villekl/EBC2013_1_2_PID/Main Board Eagle files/revB.brd

## EAGLE design Main Board Eagle files/revB.brd (2014-01-22, an earlier design)

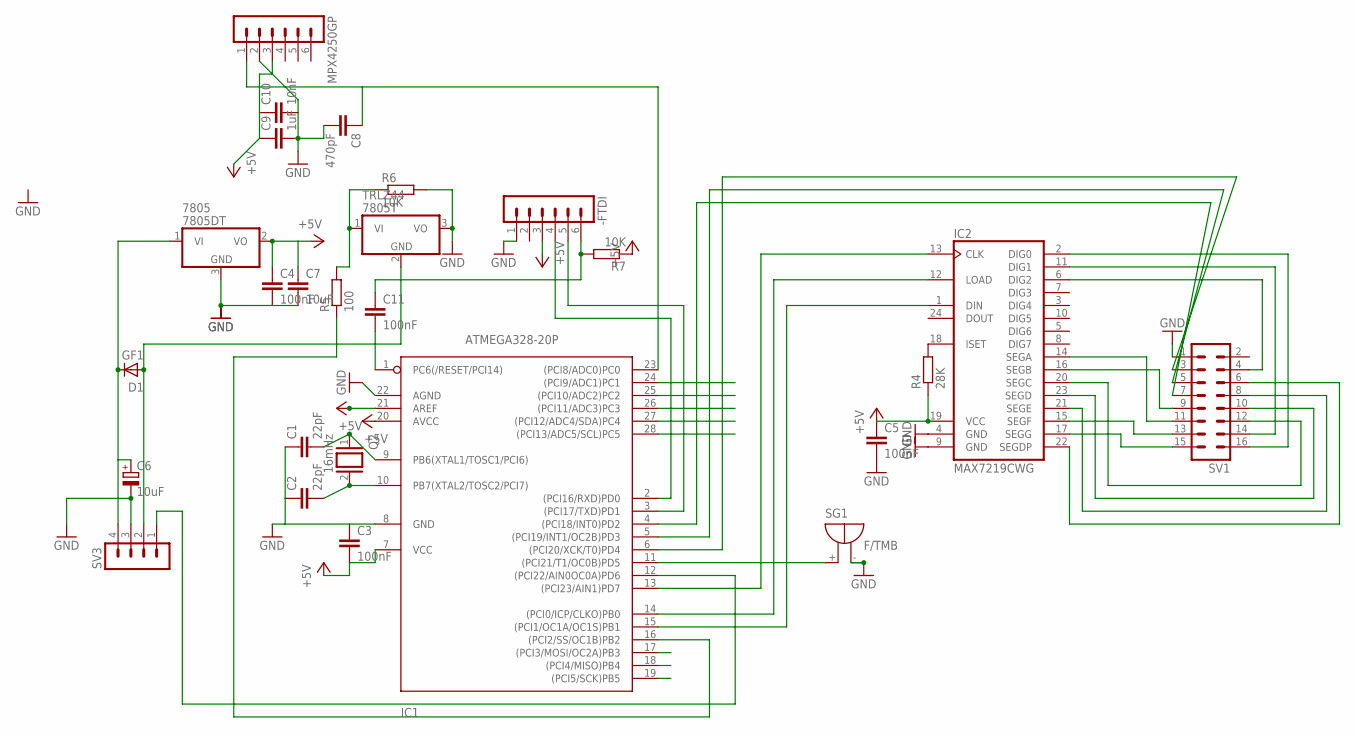
[picture p1: schematic revB.sch]

Parts:
7805: 7805DT; TO252
-FTDI: MA06-1
C1, C2: 22pF; C0805; MPN ERB21B5C2D220JDX1L
C3, C4, C5, C11: 100nF; C0805; MPN C0805X104K5RACTU
C6: 10uF; E2,5-6E
C7: 10uF; C0805; MPN C0805X104K5RACTU
C8: 470pF; C0805; MPN C0805X104K5RACTU
C9: 1uF; C0805; MPN C0805X104K5RACTU
C10: 10nF; C0805; MPN C0805X104K5RACTU
D1: GF1; SMA-DO214AC
IC1: ATMEGA328-20P; DIL28-3
IC2: MAX7219CWG
MPX4250GP: MA06-1
Q2: 16mHz; QS; MPN 16.000MHZ HC49/4H/30/50/40/18PF/ATF
R4: 28K; R0805
R5: 100; R0805
R6, R7: 10K; R0805
SG1: F/TMB
SV1: MA08-2
SV3: MA04-1
TRLZ44: 7805T; TO220H

Connections:
+5V: 7805.2 (VO), -FTDI.3, C3.2, C4.1, C5.1, C7.1, C9.1, C10.1, IC1.7 (VCC), IC1.20 (AVCC), IC1.21 (AREF), IC2.19 (VCC), MPX4250GP.3, R4.1, R7.1
GND: 7805.3 (GND), -FTDI.1, C1.1, C2.1, C3.1, C4.2, C5.2, C6.-, C7.2, C8.2, C9.2, C10.2, IC1.8 (GND), IC1.22 (AGND), IC2.4 (GND), IC2.9 (GND), MPX4250GP.2, R6.2, SG1.-, SV1.1, SV3.3, TRLZ44.3 (VO)
unnamed: C1.2, IC1.9 (PB6(XTAL1/TOSC1/PCI6)), Q2.1
unnamed: R5.2, R6.1, TRLZ44.1 (VI)
unnamed: IC1.15 ((PCI1/OC1A/OC1S)PB1), IC2.1 (DIN)
unnamed: IC2.6 (DIG2), SV1.4
unnamed: IC2.11 (DIG1), SV1.14
unnamed: IC2.22 (SEGDP), SV1.6
unnamed: IC2.21 (SEGE), SV1.8
unnamed: C8.1, IC1.23 ((PCI8/ADC0)PC0), MPX4250GP.1
unnamed: IC2.23 (SEGD), SV1.10
unnamed: IC2.20 (SEGC), SV1.12
unnamed: IC2.2 (DIG0), SV1.16
unnamed: IC2.17 (SEGG), SV1.15
unnamed: IC2.15 (SEGF), SV1.13
unnamed: IC2.14 (SEGA), SV1.11
unnamed: IC2.18 (ISET), R4.2
unnamed: IC1.16 ((PCI2/SS/OC1B)PB2), R5.1
unnamed: IC1.14 ((PCI0/ICP/CLKO)PB0), IC2.12 (LOAD)
unnamed: IC1.13 ((PCI23/AIN1)PD7), IC2.13 (CLK)
unnamed: IC1.4 ((PCI18/INT0)PD2), SV1.7
unnamed: IC1.5 ((PCI19/INT1/OC2B)PD3), SV1.5
unnamed: IC1.6 ((PCI20/XCK/T0)PD4), SV1.3
unnamed: IC1.11 ((PCI21/T1/OC0B)PD5), SG1.+
unnamed: -FTDI.6, C11.1, R7.2
unnamed: -FTDI.4, IC1.2 ((PCI16/RXD)PD0)
unnamed: -FTDI.5, IC1.3 ((PCI17/TXD)PD1)
unnamed: 7805.1 (VI), C6.+, D1.K (C), SV3.4
unnamed: C2.2, IC1.10 (PB7(XTAL2/TOSC2/PCI7)), Q2.2
unnamed: D1.A, SV3.2, TRLZ44.2 (GND)
unnamed: IC1.12 ((PCI22/AIN0OC0A)PD6), SV3.1
unnamed: IC2.16 (SEGB), SV1.9
unnamed: C11.2, IC1.1 (PC6(/RESET/PCI14))

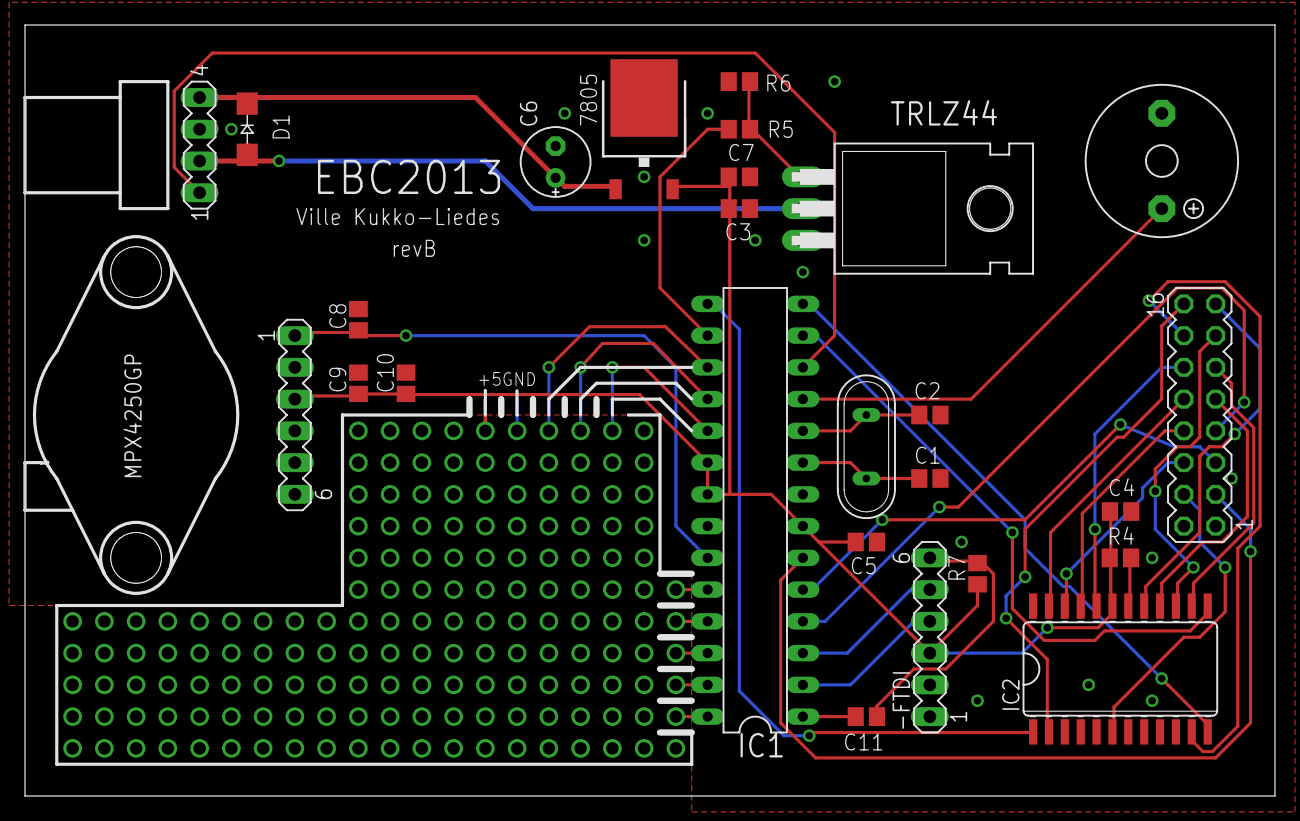
[picture p2: board revB.brd from above]

Board: 2 copper layers, 100.0 x 61.7 mm, 26 parts (0 on the bottom side), 33 nets.
