villekl/EBC2013_1_2_PID/Display Board Eagle files/rev19schem.brd

## EAGLE design Display Board Eagle files/rev19schem.brd (2014-01-22)

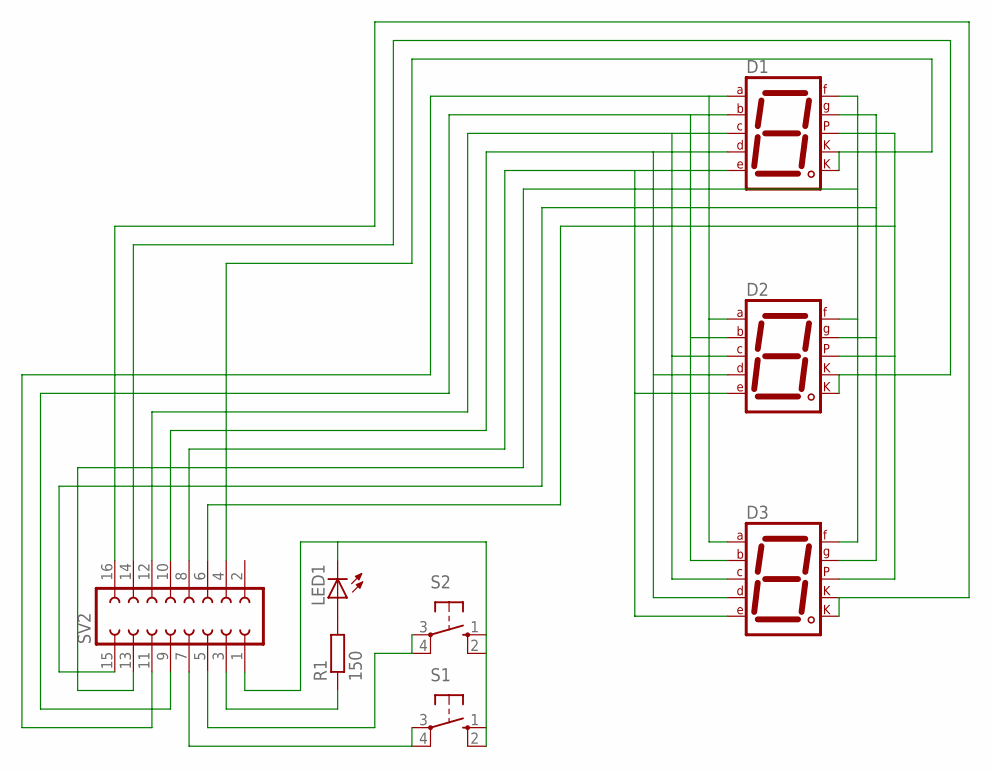
[picture p3: schematic rev19schem.sch]

Parts:
D1, D2, D3: 7SEG-CK; 7SEG-13
LED1: LED5MM
R1: 150; R0805
S1, S2: 10-XX; B3F-10XX
SV2: FE08-2

Connections:
unnamed: D1.6 (B), D2.6 (B), D3.6 (B), SV2.9
unnamed: D1.4 (C), D2.4 (C), D3.4 (C), SV2.12
unnamed: D1.2 (D), D2.2 (D), D3.2 (D), SV2.10
unnamed: D1.1 (E), D2.1 (E), D3.1 (E), SV2.8
unnamed: D1.9 (F), D2.9 (F), D3.9 (F), SV2.13
unnamed: D1.10 (G), D2.10 (G), D3.10 (G), SV2.15
unnamed: D1.5 (DP), D2.5 (DP), D3.5 (DP), SV2.6
unnamed: D1.3 (CK1), D1.8 (CK2), SV2.4
unnamed: D2.3 (CK1), D2.8 (CK2), SV2.14
unnamed: D3.3 (CK1), D3.8 (CK2), SV2.16
unnamed: D1.7 (A), D2.7 (A), D3.7 (A), SV2.11
unnamed: LED1.K (C), S1.1 (S), S1.2 (S1), S2.1 (S), S2.2 (S1), SV2.1
unnamed: LED1.A, R1.2
unnamed: R1.1, SV2.3
unnamed: S2.3, S2.4 (P1), SV2.5
unnamed: S1.3, S1.4 (P1), SV2.7

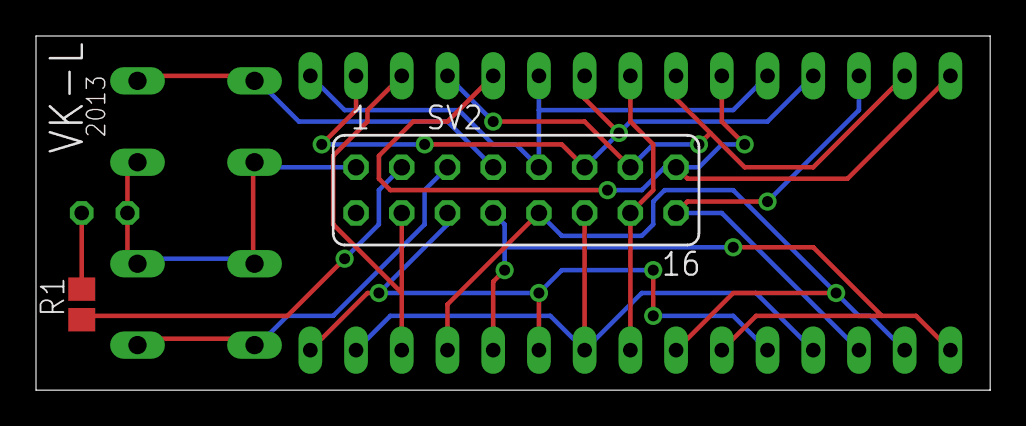
[picture p4: board rev19schem.brd from above]

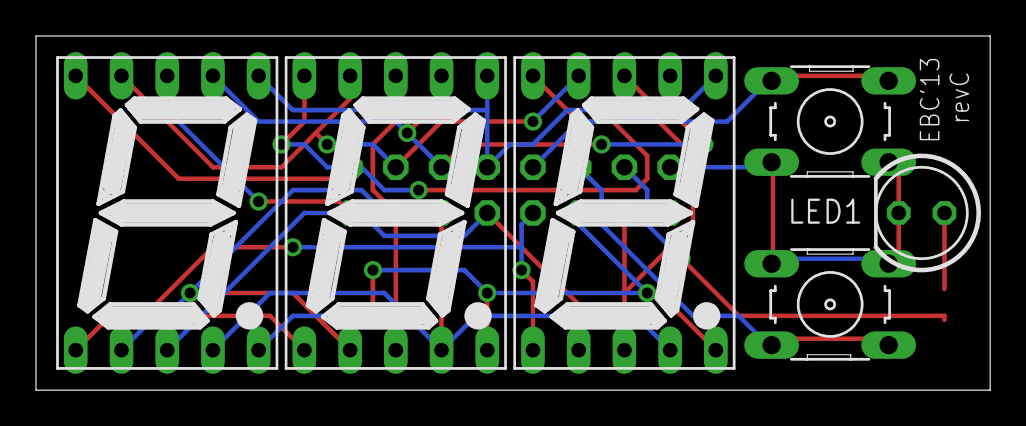
[picture p5: board rev19schem.brd from below]

Board: 2 copper layers, 53.0 x 19.7 mm, 8 parts (6 on the bottom side), 16 nets.
