villekl/EBC2013_1_2_PID/(commit log)

2014-01-20 EBC
    Arduino electronic boost controller
2014-01-22 Eagle files
    [Schem1.brd, Schem1.sch, rev19schem.brd, rev19schem.sch, revB.brd, revB.sch, revC.brd, revC.sch]
